putzio/Combat2.0/electro/OBLICZENIA.xlsx

Sheet: Obliczenie tranzystora
 | Global settings |  |  |  | Heatsink | Rth
 | Temp. ambient | Load current | Supply voltage |  | 657-25ABPE (https://www.tme.eu/pl/details/657-25abpe/radiatory/wakefield-thermal/) | 2.7
 | TA | I | U |  | SK29-38S (https://www.tme.eu/pl/details/sk29-38s/radiatory/) | 8.5
 | ℃ | A | V |  | FK210SACB (https://www.tme.eu/pl/details/fk210sacb/radiatory/fischer-elektronik/) | 18
 | 40 | 16.8 | 8.4
 | Datasheet |  |  |  |  |  |  |  | Per-device settings |  | calculated
 | Max. power dissipation | Junction temp., when PD_max is applicable | Thermal res. Junction-ambient max | Thermal res. Case-sink typical | Thermal res. Junction-case max | Gate-source voltage | Drain-source resistance in ON state | Max junction temperature | Number of transistors | Heatsink thermal res. | power to dissipate | no heatsink | with heatsink
model | PD_max | Tc(PD_max) | RthJA_max | RthCS_typ | RthJC_max | VGS | RDS(on)_max | Tj_max | n | RthSA | P | T | T_
 | W | ℃ | ℃/W | ℃/W | ℃/W | V | Ω | ℃ | - | ℃/W | W | ℃ | ℃
AO4402G (https://www.tme.eu/pl/details/ao4402g/tranzystory-z-kanalem-n-smd/alpha-omega-semiconductor/) |  |  | 75 |  |  | 2.5 | 0.0073 | 150 | 1 | none | 2.1 | 194.5 | none
AO4402G (https://www.tme.eu/pl/details/ao4402g/tranzystory-z-kanalem-n-smd/alpha-omega-semiconductor/) |  |  | 75 |  |  | 2.5 | 0.0073 | 150 | 4 | none | 0.5 | 78.6 | none
AO4402G (https://www.tme.eu/pl/details/ao4402g/tranzystory-z-kanalem-n-smd/alpha-omega-semiconductor/) |  |  | 75 |  |  | 4.5 | 0.0059 | 150 | 1 | none | 1.7 | 164.9 | none
AO4402G (https://www.tme.eu/pl/details/ao4402g/tranzystory-z-kanalem-n-smd/alpha-omega-semiconductor/) |  |  | 75 |  |  | 4.5 | 0.0059 | 150 | 4 | none | 0.4 | 71.2 | none
AOD66406 (https://www.tme.eu/pl/details/aod66406/tranzystory-z-kanalem-n-smd/alpha-omega-semiconductor/) |  |  | 50 |  |  | 4.5 | 0.0094 | 150 | 1 | none | 2.7 | 172.7 | none
AOD66406 (https://www.tme.eu/pl/details/aod66406/tranzystory-z-kanalem-n-smd/alpha-omega-semiconductor/) |  |  | 50 |  |  | 4.5 | 0.0094 | 150 | 4 | none | 0.7 | 73.2 | none
IRFP460 (https://www.vishay.com/docs/91237/91237.pdf) | 280 | 25 | 40 | 0.24 | 0.45 | 10 | 0.2700 | 150 | 1 | 2.7 | 76.2 | 3088.2 | 298.3
IRL540 (https://www.vishay.com/docs/91300/sihl540.pdf) | 150 | 25 | 62 | 0.5 | 1 | 5 | 0.0770 | 175 | 1 | 2.7 | 21.7 | 1387.4 | 131.3
IPP180N10N3G (https://www.tme.eu/pl/details/ipp180n10n3gxksa1/tranzystory-z-kanalem-n-tht/infineon-technologies/) | 71 | 25 | 62 |  | 2.1 | 6 | 0.0193 | 175 | 1 | 8.5 | 5.4 | 377.7 | 97.7
STP55NF06 (https://www.tme.eu/pl/details/stp55nf06/tranzystory-z-kanalem-n-tht/stmicroelectronics/) | 110 | 25 | 62.5 |  | 1.36 | 10 | 0.018 | 175 | 1 | 18 | 5.1 | 357.5 | 138.4

Sheet: obliczenia mostka
 |  | TB6612FNG |  | https://www.tme.eu/Document/f69c44f5b284761d41a1fa952256eb8d/TB6612FNG.pdf
Średni prąd [mA]: | 70
Maksymalny prąd [mA]: | 1600 | ostatnio tego używaliśmy?
 |  | https://botland.com.pl/sterowniki-silnikow-moduly/32-tb6612fng-dwukanalowy-sterownik-silnikow-135v1a-pololu-713-5904422307738.html
 |  | max pwm: | 100kHz
