putzio/Combat2.0/electro/combat_2.0/combat_2.0.kicad_pcb

## KiCad design electro/combat_2.0/combat_2.0.kicad_pcb (2023-04-15)

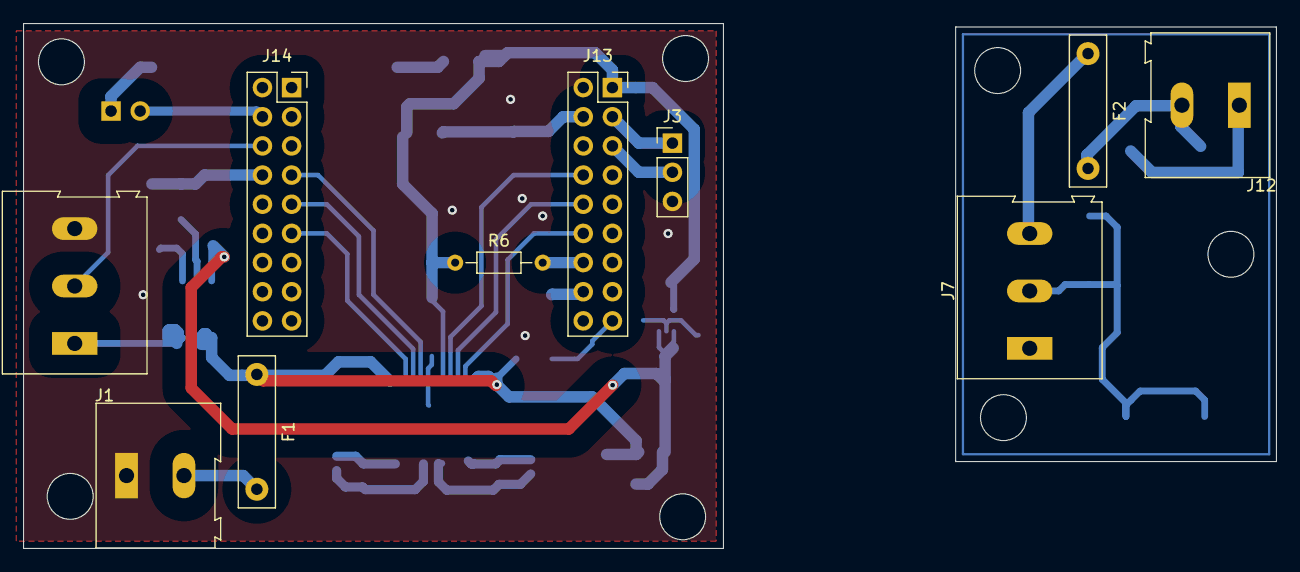
[picture p1: board combat_2.0.kicad_pcb from above]

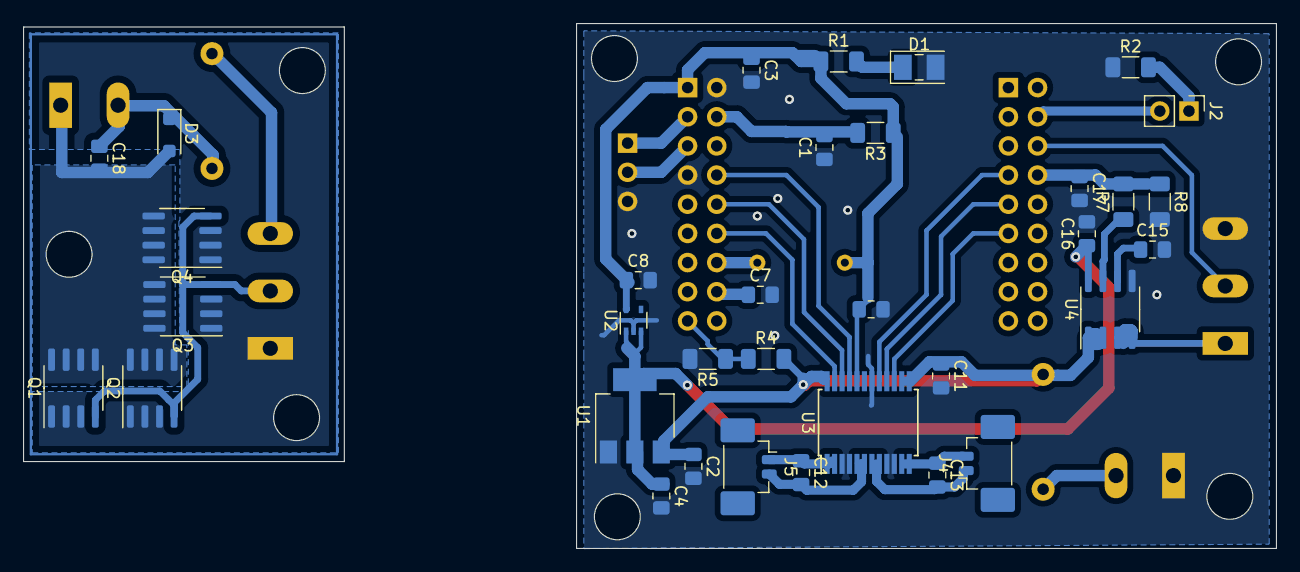
[picture p2: board combat_2.0.kicad_pcb from below]

Board: 2 copper layers, 109.1 x 45.7 mm, 44 parts (34 on the bottom side), 31 nets.

Parts:
C1, C7, C12, C13, C16, C18: 0.1uF; C_0805_2012Metric_Pad1.18x1.45mm_HandSolder
C2, C3, C4, C9, C11: 22uF; C_0805_2012Metric_Pad1.18x1.45mm_HandSolder
C8, C17: 1uF; C_0805_2012Metric_Pad1.18x1.45mm_HandSolder
C15: 1nF; C_0805_2012Metric_Pad1.18x1.45mm_HandSolder
D1: PWR; LED_PLCC-2_3x2mm_AK
D3: D; D_SOD-123F
F1: 15A; C_Rect_L13.0mm_W3.0mm_P10.00mm_FKS3_FKP3_MKS4
F2: 12A; C_Rect_L13.0mm_W3.0mm_P10.00mm_FKS3_FKP3_MKS4
J1: BATT; TerminalBlock_Altech_AK300-2_P5.00mm
J2: Conn_01x02_Socket; PinHeader_1x02_P2.54mm_Vertical
J3: UART; PinHeader_1x03_P2.54mm_Vertical
J4, J5: Conn_01x03_Pin; Molex_PicoBlade_53398-0271_1x02-1MP_P1.25mm_Vertical
J6, J7: Conn_01x03_Socket; TerminalBlock_Altech_AK300-3_P5.00mm
J12: MOT_WPN; TerminalBlock_Altech_AK300-2_P5.00mm
J13, J14: Conn_02x09_Odd_Even; PinSocket_2x09_P2.54mm_Vertical
Q1, Q2, Q3, Q4: AO4402G; SOIC-8_3.9x4.9mm_P1.27mm
R1: R; R_1206_3216Metric_Pad1.30x1.75mm_HandSolder
R2: 220; R_1206_3216Metric_Pad1.30x1.75mm_HandSolder
R3: 10kR; R_1206_3216Metric_Pad1.30x1.75mm_HandSolder
R4: 8k2R; R_1206_3216Metric_Pad1.30x1.75mm_HandSolder
R5, R8: 4k7R; R_1206_3216Metric_Pad1.30x1.75mm_HandSolder
R6: 220; R_Axial_DIN0204_L3.6mm_D1.6mm_P7.62mm_Horizontal
R7: 2k7R; R_1206_3216Metric_Pad1.30x1.75mm_HandSolder
U1: AZ1117CH-5.0TRG1; SOT-223-3_TabPin2
U2: LD29150DT33R; SOT-353_SC-70-5
U3: TB6612FNG; SSOP-24_5.3x8.2mm_P0.65mm
U4: ACS712xLCTR-20A; SOIC-8_3.9x4.9mm_P1.27mm

Connections:
+3V3: C3.1, C8.1, C9.1, J13.1, R1.1, R3.1, R6.1, U2.5 (VOUT), U3.20 (VCC)
+5V: C4.1, C16.1, U1.2 (VO), U2.1 (VIN), U2.3 (EN), U4.8 (VCC)
+8V: C2.1, C11.1, F1.1, R4.2, U1.3 (VI), U3.13 (VM2), U3.14 (VM3), U3.24 (VM1), U4.1 (IP+), U4.2 (IP+)
/BAT_LVL_ADC: J13.17, R4.1, R5.1
/DIR_A_1: J13.8, U3.21 (AIN1)
/DIR_A_2: J13.10, U3.22 (AIN2)
/DIR_B_1: J14.7, U3.17 (BIN1)
/DIR_B_2: J14.9, U3.16 (BIN2)
/ESP32 PCB adapter/EN: C1.2, J13.4, R3.2
/ESP32 PCB adapter/IO0: C7.1, J13.16
/ESP32 PCB adapter/IO16: J13.14, R6.2
/ESP32 PCB adapter/IO35: J2.2, J14.4
/MOTOR_CURRENT_ADC: C17.1, J14.8, R7.2, R8.1
/PWM_CH_A: J13.12, U3.23 (PWMA)
/PWM_CH_B: J14.11, U3.15 (PWMB)
/PWM_WEAPON: J6.2, J7.2, J14.6, Q1.4 (G), Q2.4 (G), Q3.4 (G), Q4.4 (G)
/UART_RX: J3.2, J13.5
/UART_TX: J3.1, J13.3
/weapon_motor/MOSFETS_DRAIN: C18.2, D3.2 (A), J12.1, Q1.5 (D_1), Q1.6 (D_2), Q1.7 (D_3), Q1.8 (D_4), Q2.5 (D_1), Q2.6 (D_2), Q2.7 (D_3), Q2.8 (D_4), Q3.5 (D_1), Q3.6 (D_2), Q3.7 (D_3), Q3.8 (D_4), Q4.5 (D_1), Q4.6 (D_2), Q4.7 (D_3), Q4.8 (D_4)
/weapon_motor/MOTOR_IN: C18.1, D3.1 (K), F2.2, J12.2
/weapon_motor/MOTOR_PWR: F2.1, J6.1, J7.3, U4.3 (IP-), U4.4 (IP-)
GND: C1.1, C2.2, C3.2, C4.2, C7.2, C8.2, C9.2, C11.2, C15.2, C16.2, C17.2, D1.1 (K), J1.1, J3.3, J6.3, J7.1, J13.2, J13.7, Q1.1 (S_1), Q1.2 (S_2), Q1.3 (S_3), Q2.1 (S_1), Q2.2 (S_2), Q2.3 (S_3), Q3.1 (S_1), Q3.2 (S_2), Q3.3 (S_3), Q4.1 (S_1), Q4.2 (S_2), Q4.3 (S_3), R2.1, R5.2, R8.2, U1.1 (ADJ), U2.2 (GND), U3.3 (PGND1), U3.4 (PGND1), U3.9 (PGND2), U3.10 (PGND2), U3.18 (GND), U4.5 (GND)
unnamed: D1.2 (A), R1.2
unnamed: F1.2, J1.2
unnamed: J2.1, R2.2
unnamed: C13.2, J4.1, U3.7 (BO2), U3.8 (BO2)
unnamed: C13.1, J4.2, U3.11 (BO1), U3.12 (BO1)
unnamed: C12.1, J5.1, U3.1 (AO1), U3.2 (AO1)
unnamed: C12.2, J5.2, U3.5 (AO2), U3.6 (AO2)
unnamed: C15.1, U4.6 (FILTER)
unnamed: R7.1, U4.7 (VIOUT)
