putzio/Combat2.0/(commit log)

2023-03-17 Electronical schematic
    [OBLICZENIA.xlsx, combat_2.0.kicad_pcb, combat_2.0.kicad_sch, motors.kicad_sch, weapon_motor.kicad_sch]
2023-03-18 20A Current sensor
    [combat_2.0.kicad_sch, motors.kicad_sch, weapon_motor.kicad_sch]
2023-03-20 PCB V0
    [combat_2.0.kicad_pcb, combat_2.0.kicad_sch, motors.kicad_sch, weapon_motor.kicad_sch]
2023-03-20 LDO connection fix
    [combat_2.0.kicad_pcb]
2023-03-23 Added UART connector and voltage divider for battery volt. measurement
    [combat_2.0.kicad_sch, motors.kicad_sch, weapon_motor.kicad_sch]
2023-03-23 Standarized schematic labels
2023-03-24 Changed resistors to SMD1206 type, hand-soldered version (slightly bigger pads)
    [combat_2.0.kicad_pcb, combat_2.0.kicad_sch, weapon_motor.kicad_sch]
2023-03-25 Changed MCU to ESP32-DEVKITC, cleared some ERC errors
    [combat_2.0.kicad_pcb, combat_2.0.kicad_sch, motors.kicad_sch, weapon_motor.kicad_sch]
2023-03-26 Updated some footprints
    [combat_2.0.kicad_pcb, combat_2.0.kicad_sch, motors.kicad_sch, weapon_motor.kicad_sch]
2023-03-30 Changed Devkit for ESP32-WROOM device. Added LDO, some other peripherals
    [combat_2.0.kicad_pcb, combat_2.0.kicad_sch, esp32-adapter.kicad_sch, motors.kicad_sch, weapon_motor.kicad_sch]
2023-03-30 change connectors
    [combat_2.0.kicad_pcb, motors.kicad_sch, weapon_motor.kicad_sch]
2023-04-02 competition rules
    [combat_2.0.kicad_sch]
2023-04-10 almost ready pcb
    [combat_2.0.kicad_pcb, combat_2.0.kicad_sch, esp32-adapter.kicad_sch, motors.kicad_sch, weapon_motor.kicad_sch]
2023-04-12 Changed pads to ARKs (connecting two boards together), prepared for etching
    [combat_2.0.kicad_pcb, combat_2.0.kicad_sch, weapon_motor.kicad_sch]
2023-04-12 small improvements
    [combat_2.0.kicad_pcb]
2023-04-12 Change in mosfets routing
    [combat_2.0.kicad_pcb, combat_2.0.kicad_sch, esp32-adapter.kicad_sch]
